Defdjamel/Traqueur-GPS-Arduino-Nano/preview3D_box.png

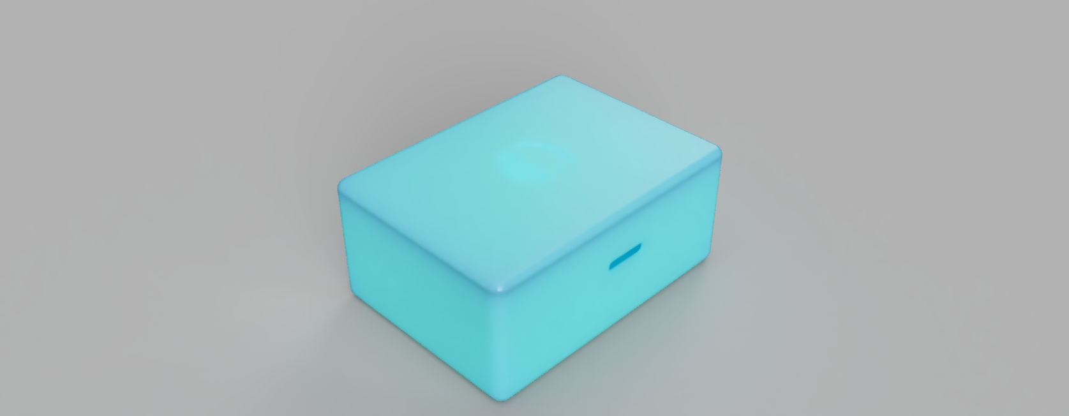
preview3D_box.png
