Defdjamel/Traqueur-GPS-Arduino-Nano/preview_plaque_soudé.jpg

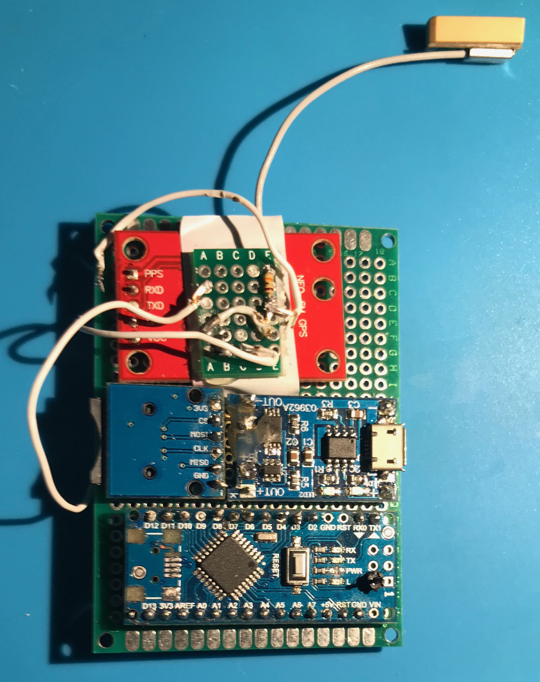
preview_plaque_soudé.jpg
