Defdjamel/Traqueur-GPS-Arduino-Nano/(threads)

Thread 1 (2024-04-10):

Résistance 1k

jmennecart, 2024-04-10:
Bonjour,
Beau projet, merci.
Je ne vois aucune trave de la résistance de 1k sur le schéma...
Je suppose qu'elle est entre la base du transistor et D8 de l'arduino ?
Cdt
